ujeshauchitha-glitch/MDP/simulation/twin/interference_adaptive_results.txt

   0.1 kHz     0 % |     0.999  |   0.0000   0.0000    0.0843 |    0.1730
   0.1 kHz     1 % |     0.998  |   0.0000   0.0000    0.0763 |    0.1617
   0.1 kHz    10 % |     0.999  |   0.0000   0.0000    0.7555 |    0.0058
   0.1 kHz   100 % |     0.000  |   0.0000   0.0000    0.0002 |    0.0000
   1.0 kHz     0 % |     1.000  |   0.0000   0.0000    0.0817 |    0.1637
   1.0 kHz     1 % |     0.998  |   0.0000   0.0000    0.6650 |    0.0102
   1.0 kHz    10 % |     0.000  |   0.0000   0.0000    0.0000 |    0.0000
   1.0 kHz   100 % |     0.000  |   0.0000   0.0000    0.0000 |    0.0000
  10.0 kHz     0 % |     0.997  |   0.0000   0.0000    0.0782 |    0.1528
  10.0 kHz     1 % |     0.999  |   0.0000   0.0000    0.3445 |    0.0025
  10.0 kHz    10 % |     0.000  |   0.0000   0.0000    0.0000 |    0.0000
  10.0 kHz   100 % |     0.000  |   0.0000   0.0000    0.0000 |    0.0000
