ujeshauchitha-glitch/MDP/simulation/twin/interference_results.txt

      1 % (   1.0 nA)      0.1 kHz |     0.997            1.000        |     0.015 mV
     10 % (  10.0 nA)      0.1 kHz |     0.165            1.000        |     0.147 mV
    100 % ( 100.0 nA)      0.1 kHz |     0.014            0.886        |     1.475 mV
   1000 % (1000.0 nA)      0.1 kHz |     0.000            0.582        |    14.748 mV
      1 % (   1.0 nA)      1.0 kHz |     0.139            1.000        |     0.147 mV
     10 % (  10.0 nA)      1.0 kHz |     0.000            0.912        |     1.475 mV
    100 % ( 100.0 nA)      1.0 kHz |     0.000            0.572        |    14.748 mV
   1000 % (1000.0 nA)      1.0 kHz |     0.000            0.509        |   147.479 mV
      1 % (   1.0 nA)     10.0 kHz |     0.000            1.000        |     0.255 mV
     10 % (  10.0 nA)     10.0 kHz |     0.000            0.850        |     2.549 mV
    100 % ( 100.0 nA)     10.0 kHz |     0.000            0.539        |    25.488 mV
   1000 % (1000.0 nA)     10.0 kHz |     0.000            0.500        |   254.875 mV
      1 % (   1.0 nA)    100.0 kHz |     0.000            1.000        |     0.203 mV
     10 % (  10.0 nA)    100.0 kHz |     0.000            0.920        |     2.033 mV
    100 % ( 100.0 nA)    100.0 kHz |     0.000            0.564        |    20.329 mV
   1000 % (1000.0 nA)    100.0 kHz |     0.000            0.514        |   203.287 mV
