ujeshauchitha-glitch/MDP/simulation/spice/results_real/detect_results.txt

N=48 chips @ 480 kchip/s, T_int=100 us, Pfa=1e-08, eta=5.61 sigma
required d = 8.70 (18.8 dB) for Pd = 0.999

I_DC=10n: rx delay 1.30 us, sigma0=8.529 uV, noise-only skew=+0.020 kurt=3.034 P(|z|>3s)=0.0027 (Gauss 0.0027) P(|z|>4s)=0.00005 (Gauss 6.3e-5)
   m= 2.0%  d=  3.78  SNR= 11.5 dB  Pd@Pfa1e-8=0.03931 (empirical 0.0394)
   m= 1.0%  d=  1.89  SNR=  5.5 dB  Pd@Pfa1e-8=0.0001107 (empirical 0.0001)
   m= 0.5%  d=  0.94  SNR= -0.6 dB  Pd@Pfa1e-8=1.462e-06 (empirical 0.0000)

I_DC=30n: rx delay 1.30 us, sigma0=8.551 uV, noise-only skew=+0.035 kurt=3.026 P(|z|>3s)=0.0029 (Gauss 0.0027) P(|z|>4s)=0.00005 (Gauss 6.3e-5)
   m= 2.0%  d= 11.29  SNR= 21.1 dB  Pd@Pfa1e-8=1 (empirical 1.0000)
   m= 1.0%  d=  5.66  SNR= 15.0 dB  Pd@Pfa1e-8=0.5161 (empirical 0.5145)
   m= 0.5%  d=  2.82  SNR=  9.0 dB  Pd@Pfa1e-8=0.003371 (empirical 0.0035)

I_DC=100n: rx delay 1.30 us, sigma0=8.974 uV, noise-only skew=-0.009 kurt=3.017 P(|z|>3s)=0.0029 (Gauss 0.0027) P(|z|>4s)=0.00005 (Gauss 6.3e-5)
   m= 2.0%  d= 35.87  SNR= 31.1 dB  Pd@Pfa1e-8=1 (empirical 1.0000)
   m= 1.0%  d= 17.92  SNR= 25.1 dB  Pd@Pfa1e-8=1 (empirical 1.0000)
   m= 0.5%  d=  8.97  SNR= 19.1 dB  Pd@Pfa1e-8=0.9975 (empirical 0.9980)

I_DC=300n: rx delay 1.30 us, sigma0=9.992 uV, noise-only skew=+0.003 kurt=3.024 P(|z|>3s)=0.0029 (Gauss 0.0027) P(|z|>4s)=0.00015 (Gauss 6.3e-5)
   m= 2.0%  d= 96.48  SNR= 39.7 dB  Pd@Pfa1e-8=1 (empirical 1.0000)
   m= 1.0%  d= 48.28  SNR= 33.7 dB  Pd@Pfa1e-8=1 (empirical 1.0000)
   m= 0.5%  d= 24.12  SNR= 27.6 dB  Pd@Pfa1e-8=1 (empirical 1.0000)

I_DC=1u: rx delay 1.30 us, sigma0=13.249 uV, noise-only skew=+0.025 kurt=3.003 P(|z|>3s)=0.0024 (Gauss 0.0027) P(|z|>4s)=0.00005 (Gauss 6.3e-5)
   m= 2.0%  d=242.77  SNR= 47.7 dB  Pd@Pfa1e-8=1 (empirical 1.0000)
   m= 1.0%  d=121.32  SNR= 41.7 dB  Pd@Pfa1e-8=1 (empirical 1.0000)
   m= 0.5%  d= 60.64  SNR= 35.7 dB  Pd@Pfa1e-8=1 (empirical 1.0000)
