ujeshauchitha-glitch/MDP/(commit log)

2026-09-23 L1 arch: dual-path shared-buffer front end, Pd/Pfa-derived detection spec, I_DC-swept noise budget
    Latency (not security) is the architecture driver: a 5kHz path can't
    produce a per-sample flag inside a 100us window. Replaces flat SNR>50dB/
    <500ns targets with a matched-filter Pd/Pfa derivation and a functional
    timing spec. Correlator SNR unmeasured pending bench I_DC/I_amb.
2026-09-28 L1 arch v2: separate Pfa from attacker-guess security, resize wideband path for N=48
    Splits detection-theoretic Pfa (AWGN, from integration time) from
    cryptographic 2^-N (attacker guessing, from code entropy) - N never
    appeared in the SNR formula and was being conflated with security
    margin. Flags that a plain LFSR's real security is bounded by register
    length via Berlekamp-Massey, not chip count - unresolved, needs crypto
    review. Spends the resulting N=48 headroom on bandwidth: Rf_wide
    72.4k -> 314k, +6.2dB at the worst-case low-I_DC point. Adds named
    clinical limitation (verifier fails on high-melanin/low-perfusion
    patients) and checks that adaptive wavelength selection reinforces the
    fix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
2026-10-15 Run TIA in ngspice: fix netlist, add wideband TIA, record measured results
    First real simulation of the L1 AFE. Netlist fixes: X-prefixed sky130
    subckt instances and scale, PMOS pseudo-resistor (0.997 GOhm), Rsh removed,
    DC nodeset, valid gain/rise measurements. New tia_wide.spice (314k, 483 kHz,
    no peaking). Runner now builds a trimmed sky130 model lib. Docs updated with
    measured numbers and the spec misses they expose.
2026-10-16 Update xschem schematic to match simulated netlist (PMOS pseudo-resistor, no Rsh, Cf 1f, pulse source)
2026-10-16 Add regulated-cascode + current-mirror input split (afe_front) and results
    Generator + netlist + AC/noise driver. Wideband path works (314 kOhm) but
    noise/BW trade-off misses the spec; slow path needs a DC servo. Documented
    in afe-architecture s12.
2026-10-16 Add slow-path DC servo: behavioral integrator + real PMOS cancel device
    Power-up transients at I_DC=100n and 1u acquire lock (s_in 1.650 V, s_out
    within a few mV of VCM, 10 pA pulse gives ~10 mV). Documents failures found
    (Msv power-up, coarse acquisition, gmin) and that noise is estimated only.
2026-10-16 Simulate slow-path noise with mirror + servo; IBX and area sweeps
    Slow-path input-referred noise is dominated (~90%) by mirror flicker noise,
    not the servo device: 50-325 pA RMS vs 4 fA/rtHz Rf floor. Corrects the
    earlier estimate in s13.
2026-10-16 Simulate option 1: slow path direct off the photodiode, AC-coupled wideband mirror
    Slow-path noise 8.3 pA RMS (0.5-100 Hz) vs 237 pA with the mirror (~29x),
    gain 1.00 GOhm unaffected; wideband BW/noise about equal to mirror-only.
    Cancel device flipped to an NMOS sink. Coupling cap area is the cost.
2026-10-16 Reduce wideband noise: drop the non-regulating booster, tune IBX, 4x degenerated mirror
    Min I_DC for Pd>=99.9% at Pfa=1e-8 improves ~2.1x (m=2%: 50->24 nA, 1%: 100->48,
    0.5%: 200->95) per the full coherent-detection Monte Carlo. Booster found to be
    pinned (gc~0V) in all earlier runs; forcing regulation was worse.
2026-10-16 Replace ideal IBX/cancel/gate-bias sources with a real degenerated PMOS mirror
    Penalty is ~0.1-0.2 dB SNR (min I_DC +2.5%: 24/49/97 nA at m=2/1/0.5%).
    Gate bias is Vgc=0 = ground. Adds real_bias_sweep.py, REAL=1 channel
    extraction and results_real/ Monte Carlo output.
2026-10-16 PVT check: wideband path robust (14-52 nA min I_DC), slow-path pseudo-resistor spans 0.8 MOhm-120 GOhm
    Adds corner/temperature support (lib swap, .temp, tight solver tolerances)
    and corner_run.py. Fixes two analysis bugs (wrdata column offset, sign of mu).
2026-10-16 Slow path: poly T-network feedback is PVT-robust (0.986-0.995 GOhm at all corners)
    Replaces the PMOS pseudo-resistor (0.8 MOhm-120 GOhm over PVT). Slow BW 2.5-3.0 kHz
    and noise unchanged; wideband worst case improves 52.4 -> 28.4 nA. corner_run.py now
    uses tight solver tolerances only for the slow path (they corrupt wideband .noise).
2026-10-16 Add docs/STATUS.md: current design, headline numbers, superseded claims, open items
    Also points the top of afe-architecture.md at it.
2026-10-16 Supply sensitivity: design broke at VDD-10% (headroom); fix is VCM 1.65->1.4 V
    At 2.97 V with VCM=1.65 the min I_DC rose to 82-135 nA and the slow Z collapsed to 0.3-0.4 GOhm.
    With VCM=1.4 V the PVT x supply matrix holds slow Z within 1.5% and wide min I_DC 20.8-29.2 nA.
    Adds vdd/vcm options, results/supply_sweep.txt, updates STATUS.md.
2026-10-16 Digital DC-cancellation servo: ADC + SAR acquisition + integrator + 12-bit DAC with sigma-delta fine path
    Closed-loop co-sim against the SPICE plant/noise. Locks in ~90 ms, PPG gain 0.994, no added noise,
    cross-checked in transistor-level SPICE (3.6 mV rms diff). Finds a 1 GOhm PPG amplitude ceiling
    (~150-250 pA) and unusability above ~1 uA I_DC -> needs a switchable transimpedance.
2026-10-16 Switchable slow-path transimpedance (1G/100M/10M) with auto-range from the servo DAC code
    SPICE ranges hold Z within 0.5% over PVT; closed-loop auto-ranging from power-up gives PPG gain
    0.9986-0.9989 for I_DC 5 nA-1 uA with no re-acquisitions. Fixes the 1 GOhm clipping/unusable-above-1uA
    problem found in the servo study. Also fixes the plant-fit bounds and the lock scan start.
2026-10-16 Spoofing study: correlation-only detector is passable; residual test, relay attack, LFSR predictability
    Blind injection at legit amplitude passes D0 16% (50% loud); a residual/goodness-of-fit test (D1) rejects blind
    attacks at 0.1%-pt Pd cost but a <=130 ns optical relay passes 97-100%. LFSR-32 predicted 100% after 64 chips.
    Corrects the 2^-N claim in section 1a.
2026-10-17 Mismatch worst-case sensitivity (+/-5 mV mirror/bias, +/-10 mV op-amp): <=1% effect
    Adds gate-offset hooks to the netlist builder and mismatch_sens.py. PDK 5V models have no usable random
    mismatch (vth0_slope=0), so offsets are injected by hand with assumed Pelgrom coefficients.
2026-10-17 PSRR: poor in both paths; sets a supply-noise budget (15 nV/rtHz @100 Hz slow, 36-110 nV/rtHz @100-300 kHz wide)
    i_eq rises ~ f for the slow path (58 nA/V at 1 kHz), unaffected by the bias network, consistent with op-amp
    supply sensitivity times TIA noise gain (inferred). Adds psrr.py and results/psrr.txt.
2026-10-17 PSRR addendum: cascoding the second-stage load does not fit (0.62 V headroom); lists fix routes
2026-10-17 Supply rejection fixed: Mc body effect was the cause (not the op-amps)
    Mc well on VCM + supply-independent bias reference cut supply-equivalent input current 68-223x (slow)
    and 39-210x (wide, 10-100 kHz); PVT x supply matrix unchanged (min I_DC 21-29 nA) and bias current now
    300 nA at every corner. Corrects the section 27 diagnosis; opamp2 (no follower + cascode) not adopted.
2026-10-17 Supply rejection round two: op-amp input-pair body effect; all four fixes hold over PVT x supply
    Found by bisecting blocks onto separate DC supplies. Slow-path supply-equivalent input current 527-3200x
    lower than the original, wideband 24-13000x; min I_DC 21-29 nA unchanged. Adds inbulk/ibias/cpb/ccas options
    and results/psrr_final.txt. Records three falsified hypotheses.
2026-10-17 Re-run detection Monte Carlo on the final front end: min I_DC 24/49/97 nA unchanged
    Channel extracted with all supply/headroom fixes; default solver tolerances (tight tolerances corrupt wideband .noise);
    six-digit Msv gate voltages. Adds results_final/ and FINAL=1 mode in make_chan_opt.py.
2026-10-17 Range switches as real NMOS: 2-13 mV glitch, <=1 mV leakage shift even at 125C, instant settling
    Adds range_switch_tran.py and results/range_switch.txt.
2026-10-17 Power budget (268 uW baseline) and a 4x lower-power op-amp bias (66 uW, reach 2-4% worse)
    Op-amp bias 0.5u/1u with Cf 150f/500f/1.5p per range removes the GBW-induced peaking; wideband min I_DC unchanged at
    tt/27 and 2-4% worse over PVT. Adds results/lowpower.txt; digital power not included.
2026-10-17 Add power, bias/peaking and supply-bisect analysis scripts to tools/ for reproducibility
2026-10-17 Low-power config re-checks: PSRR as good or better, servo/auto-range unchanged (plants overdamped)
    Adds SERVO_DATA_PREFIX switch for the servo plants and results_lowpower.txt.
2026-10-17 Measured loop gain / phase margin of the final TIAs: low-power config PM 62-80, baseline slow loop 48
    Adds loopgain_final.py and results. Larger Cf at low bias improves damping.
2026-10-17 Audit: validate MC engine analytically, confirm cancel-device noise dominance, correct supply-noise budgets and stale STATUS entries
    New test_mc_analytic.py (0.1% vs closed form). Tolerance 'artifact' explanation downgraded to unreproduced (outliers were below the
    physical floor). Recomputed supply-noise budgets (sections 28/29) after finding arithmetic errors. Adds section 33.
2026-10-17 Audit follow-up: tight tolerances demonstrably corrupt noise for some circuits; matrix re-run unchanged; sink degeneration cuts slow noise 4.7-8x
    corner_run.py now analyses slow noise with default tolerances. Adds sdeg option, section 34 and results/sdeg_and_matrix_audit.txt.
2026-10-17 Audit addendum: noise normalisation verified (1k resistor), generators clean, plant fit quality, spoof study re-run on final channel
2026-10-17 Status report 2 (audit, cancel-device noise, long integration); servo study with degenerated sink (+13 to +17.5 dB PPG SNR)
    Adds SERVO_PSD_DIR option, data_sd noise spectra, results_sdeg.txt, section 36, report index and progress-log updates.
2026-10-17 DAC unit-cell sizing: degeneration (0.3 V drop) matters more than area; noise ~ area^-0.4
    Adds msvm/msvl options and results/sink_area.txt (section 37).
2026-10-17 Segmented cancel device check (seg= option): n unit cells give the same noise as one device; status report 4
2026-10-17 Twin stage 1: Trivium keyed chip-code generator (matches eSTREAM test vector)
2026-10-17 Twin stage 2: end-to-end digital twin (fast+slow path, Trivium, attacks), validated against SPICE studies
2026-10-17 Relay-attack study, chip-generator decision (Trivium), twin validation results in docs (s40)
2026-10-17 Gate-voltage DAC option (gdrv/gcap) and result: 100k DAC output resistance adds <0.1 pA
2026-10-17 Fast-path digitisation study: >=4 samples/chip and LSB <=300 uV cost <=0.6 dB (twin)
2026-10-17 Converter design (gate-voltage DAC), fast-path digitisation, area/power budget (s41); STATUS updated
2026-10-17 Status report 5: digital twin, decisions, converter, digitiser, area and power; index and log
2026-10-17 Area stage 1: per-range T-networks replace the 111M parallel resistor; Cc sweep; revised budget (s42)
2026-10-17 RTL stage 1: Trivium in Amaranth HDL (matches the Python reference), yosys synthesis flow, 301 FF / 522 gates (~8.9k um2)
2026-10-17 RTL stage 2: fast-path verifier (LP biquad + shift high-pass template, correlator, residual compare), bit-exact vs the fixed-point model; synthesis 464 FF / 5553 gates (~43k um2 cell area)
2026-10-17 RTL stage 3: servo with auto-ranging in Amaranth (closed-loop co-sim with fitted plants: lock 25 ms, ranges and codes correct); synth results for all blocks
2026-10-17 Verifier narrowed to 6-bit samples, budget from synthesised blocks, docs s44 (RTL results)
2026-10-17 Ambient interference study: fixed residual thresholds fail at 1% flicker, adaptive thresholds from dark frames restore operation up to 10%/1% (s47)
2026-10-17 Flicker-noise model check (s48): NMOS 3.7e-10 V^2um^2; unverified against silicon; fix interference docstring
